dani1560/SDR_Doppler_Radar_Pluto/photos/pluto_board_DFU_button_S1.jpeg

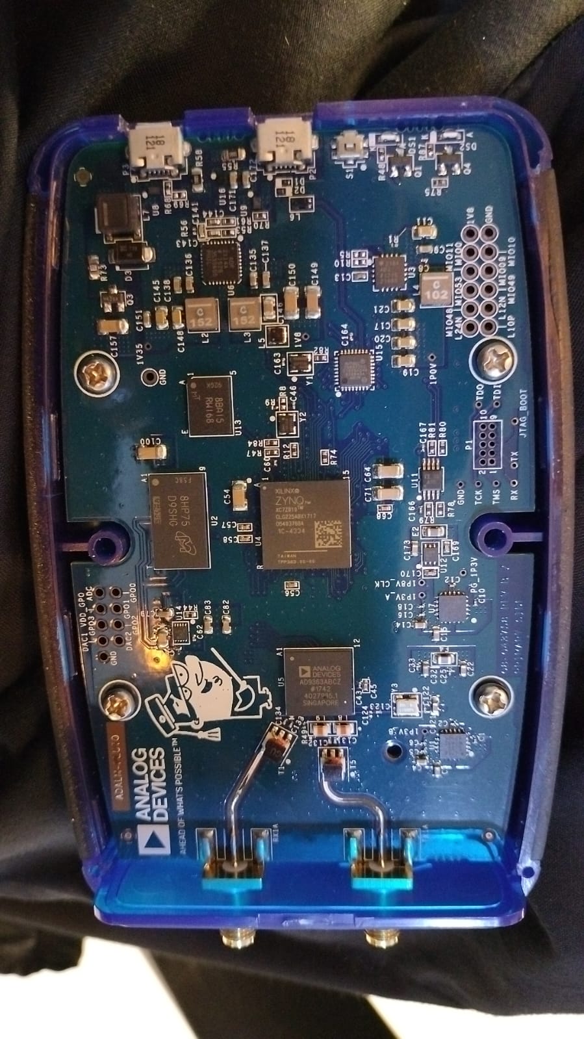
photos/pluto_board_DFU_button_S1.jpeg
