dani1560/SDR_Doppler_Radar_Pluto/docs/SDR_Radar_Deployment_Guide.pdf

Deployment Guide | SDR-Based Doppler Radar | PNEC-NUST

Final Year Project - Electronics & Power Engineering

# Run the Radar on a New Laptop

5 steps - about 30 minutes - internet needed once

1

Download the project: github.com/dani1560/SDR_Doppler_Radar_Pluto → Code → Download ZIP → unzip it.

2 Install Python from python.org. On the first screen tick Add python.exe to PATH.

3

Install the Pluto driver (Pluto unplugged): open the SDR_Radar_Deploy folder, double-click TOOLS.bat, press 6, click Yes to everything, then press 0.

4

Install GNU Radio: download radioconda for Windows from github.com/radioconda/radioconda-installer/releases and install it. Untick Add to PATH.

5

Plug in the Pluto (middle USB port) and the Arduino, wait 30 s, then double-click START_GNURADIO.bat.

Done. Stand still for 3 seconds, then move straight towards the antennas. Close the window to stop.

If something does not work

Problem | Fix
Pluto not found | Use the middle USB port, wait 30 s, close any other radar window
Arduino not found | Install the CH340 driver (wch-ic.com) or try another USB cable
Nothing detected | Move closer and straight towards the antennas; set the Min signal slider to 12
