dani1560/SDR_Doppler_Radar_Pluto/SDR_Radar_Deploy/03_alarm_test.py

"""
Step 3 - Arduino alarm test (no Pluto needed).

Sends simulated passes to the Arduino Nano so you can check the buzzer and LED display:
  1. slow, far   -> quiet, slow beeps
  2. medium      -> louder, faster beeps
  3. fast, close -> loudest, highest pitch, fastest beeps
After each pass the LED display should hold that pass's speed (one decimal, e.g. 15.0);
the fast pass is over the limit, so its speed blinks (captured).

Run:  python 03_alarm_test.py COM5      (or: python 03_alarm_test.py auto)
(Close the Arduino IDE Serial Monitor first.)
"""
import sys
import time
import serial

MAX_KMH = 60
PASSES = [            # (description, peak speed km/h, peak proximity %)
    ("slow and far", 15, 20),
    ("medium", 35, 60),
    ("fast and close", 72.4, 100),
]


def send(port, kmh, proximity, last):
    volume = min(max(kmh / MAX_KMH, 0.1), 1.0) * 100 if proximity > 0 else 0
    captured = int(last > MAX_KMH)                  # over the limit: the display blinks the held speed
    port.write(f"S{kmh:.1f},P{proximity:.0f},V{volume:.0f},L{last:.1f},F{captured}\n".encode())


def main():
    if len(sys.argv) < 2:
        print("Usage: python 03_alarm_test.py COM5   (or 'auto')")
        sys.exit(1)

    name = sys.argv[1]
    if name.lower() == "auto":
        from arduino_port import find_arduino_port
        name = find_arduino_port()
        if not name:
            sys.exit("No Arduino found. Is the Nano plugged in (and the CH340 driver installed)?")
        print(f"Arduino found on {name}")
    try:
        port = serial.Serial(name, 115200, timeout=0)
    except serial.SerialException as e:
        sys.exit(f"Cannot open {name}: {e}\nClose the Arduino IDE / Serial Monitor and try again.")
    time.sleep(2)                       # Nano resets when the port opens (8888 + chirp)
    last = -1.0

    try:
        for desc, peak_kmh, peak_prox in PASSES:
            print(f"Pass: {desc} - up to {peak_kmh} km/h, proximity {peak_prox}%")
            for i in range(40):          # 2 s approach: proximity and speed ramp up
                f = (i + 1) / 40
                send(port, peak_kmh * (0.8 + 0.2 * f), peak_prox * f, last)
                time.sleep(0.05)
            last = float(peak_kmh)
            note = "  (over the limit: blinking)" if last > MAX_KMH else ""
            print(f"  passed -> display should hold {last:.1f}{note}")
            for _ in range(60):          # 3 s quiet: display holds last speed
                send(port, 0, 0, last)
                time.sleep(0.05)
        print(f"Done. Display should show {last:.1f} (blinking)")
    finally:
        port.close()


if __name__ == "__main__":
    main()
