dani1560/SDR_Doppler_Radar_Pluto/(commit log)

2026-10-23 FYP SDR DOPLER RADAR PLUTO
    Low-cost SDR-based CW Doppler radar using ADALM-PLUTO at 2.48 GHz to measure vehicle speed in real time. Python DSP extracts the Doppler shift via FFT, rejects fan/Wi-Fi clutter, and logs each pass. An Arduino drives a buzzer that grows louder with speed and faster as targets approach, and an LED display holds the last measured speed.
    [01_pluto_test.py, 02_doppler_radar.py, 03_alarm_test.py]
2026-10-23 FYP SDR Doppler Radar
    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
    [01_pluto_test.py, 02_doppler_radar.py, 03_alarm_test.py, speed_alarm.ino]
2026-10-27 Add one-click launcher and make TX shutdown reliable
    - START_RADAR.bat: checks Python, packages and libiio, finds the Pluto
    and Arduino, and offers a menu (radar, tests, sketch upload, drivers).
    Replaces install.bat, run_radar.bat and run_radar_arduino.bat.
    - 02_doppler_radar.py: TX is destroyed and muted (-89 dB) on every exit
    path, including startup errors and console close; --port auto; the
    last pass is logged on exit; the display keeps the last speed.
    - 01_pluto_test.py: cleanup covers TX start, no cyclic-buffer phase jump,
    RX gain 30 dB (50 dB saturated with the antennas close together).
    - 03_alarm_test.py: accepts 'auto' for the COM port.
    - README updated for the launcher, an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
    [01_pluto_test.py, 02_doppler_radar.py, 03_alarm_test.py, arduino_port.py]
2026-10-27 Add speed-camera mode, simpler launcher, docs and PDF guides
    - Speed camera: each pass's peak speed is held and logged; passes over
    --limit are captured (red on screen, blinking on the LED, CSV column).
    - Sub-bin peak interpolation for a 0.1 km/h readout.
    - START_RADAR.bat starts the radar directly; TOOLS.bat holds the menu.
    - LED shows whole km/h on colon-only TM1637 modules (HAS_DOTS for modules
    with decimal points).
    - Root README, DEPLOY.md, project overview and student build guide PDFs.
2026-10-29 Add GNU Radio version with live frequency and max-speed control
    - gnuradio/doppler_radar.grc: PlutoSDR source/sink, Frequency Xlating FIR and
    FIR decimation to 8 kS/s, Doppler spectrum and waterfall, live/held speed
    labels, and sliders for frequency, max speed, speed limit, RX gain and TX
    attenuation.
    - gnuradio/doppler_camera_block.py: embedded Python "Doppler Speed Camera"
    block (detection, capture, log, Arduino); mutes TX when the flowgraph stops.
    - doppler_core.py: detector, speed conversion, pass tracking and logging shared
    by the GNU Radio and Python versions; frequency and max speed are parameters.
    - 02_doppler_radar.py: uses doppler_core; new --freq-mhz and --max-speed.
    - S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
2026-10-29 Show the last logged pass on the LED after a restart
    The Nano resets whenever the serial port opens and forgets the held speed.
    SpeedCamera now loads the last pass from speed_log.csv at start-up, so the
    LED and the GNU Radio LAST SPEED label show it until the next pass.
    [doppler_core.py]
2026-10-29 GNU Radio: warn on the screen when the receiver clips
    The TX-to-RX leakage is 0.8 of ADC full scale at the default settings, so
    less TX attenuation overloads the receiver. LIVE SPEED now shows a CLIPPING
    warning above 0.9 of full scale (tested: TX 5 dB/RX 30 dB clips, TX 0 dB/RX
    20 dB does not).
    [doppler_camera_block.py]
2026-10-29 Short-range defaults (about 1-2 m) and a Min signal setting
    - New Min signal slider (GNU Radio) and --min-signal option (Python): the
    signal a target needs above the noise. Higher = only closer targets.
    - Defaults for indoor demos: TX attenuation 30 dB, RX gain 30 dB, Min signal
    35 dB, Max speed 60 km/h, Speed limit 10 km/h. Tested with injected targets:
    a strong (near) target is measured within 0.02 km/h, a weak (far) one ignored.
    - TX attenuation 30 also keeps the TX leakage at 0.08 of full scale instead of
    0.8, which raised the test-target signal from 19 dB to 42 dB.
    - README: settings table and long-range settings.
    [02_doppler_radar.py, doppler_camera_block.py, doppler_core.py]
2026-10-29 Faster LED update, blink on every new speed, max 50 km/h
    - FFT window 0.5 s -> 0.26 s (NFFT 2048) and pass end 1 s -> 0.4 s: the held
    speed reaches the LED about 0.75 s after the target leaves (was 2-3 s).
    Measured on the Pluto: 5-45 km/h within 0.04 km/h, both directions.
    - speed_alarm.ino: every new captured speed blinks for 5 s; a pass over the
    limit keeps blinking.
    - Max speed default 50 km/h (GNU Radio and Python).
2026-10-29 Toy-car defaults: TX attenuation 20 dB, Min signal 15 dB
    A toy car echoes much less than a person. Measured in a 90 s room test with
    these settings: no false detections while nothing moved, and the car was
    detected when driven straight at the antennas (3-17 km/h, up to 47 dB).
2026-10-29 Update both PDFs and README for the current GNU Radio build
    - Six sliders incl. Min signal, default settings table with block IDs and how
    to change defaults in GNU Radio Companion.
    - Current numbers: 2048-point FFT (3.9 Hz bins, 0.85 km/h, 0.1 km/h readout),
    max speed 50 km/h default, held speed ~0.75 s after the target leaves.
    - LED behaviour (5 s blink, kept blinking over the limit, restored after a
    restart), range tips (toy car), room and toy car test results.
    - New figures: radar controls and Doppler spectrum.
2026-10-29 Presentation: replace MATLAB with GNU Radio
    Slides 4, 8, 9 and the block diagram image on slide 10 named MATLAB as the
    processing platform. They now say GNU Radio (3.10, gr-iio PlutoSDR blocks);
    everything else in the deck is unchanged. PDF re-exported from PowerPoint.
2026-10-29 PDFs: guide code examples match the current code; deck author
    - Student guide: detection example is now doppler_core.Detector (clutter map,
    Min signal, five candidate peaks); pass tracking is SpeedCamera.update; TX
    attenuation -20 dB; Python-only steps say so; held-speed timing (0.75 s).
    - Exercises kept on one page.
    - Presentation: author set to the project team (was the library name).
2026-10-29 Presentation matches the built project; current screenshots everywhere
    Deck (now 17 slides):
    - 2.482 GHz carrier, AD9363 / 20 MHz, specs from the code (2048-point FFT,
    0.85 km/h bins with 0.1 km/h readout, 50 km/h default up to 740 km/h).
    - Signal processing flow: mixing to 0 Hz and 8 kS/s, FFT with clutter map,
    output in GNU Radio and on the LED.
    - New system diagram: one PlutoSDR (TX and RX), one laptop with the GNU Radio
    blocks, Arduino LED and buzzer, speed log.
    - New slides: GNU Radio Implementation (radar window) and Test Results.
    - Budget: miscellaneous is the Arduino, LED display and buzzer.
    - Conclusion names the speed camera, LED display and adjustable settings.
    Overview / gu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
2026-10-29 Louder buzzer: 1.8-3.6 kHz tone, 30-50 % duty cycle
    A passive buzzer is loudest around 2-4 kHz; the old 600-1200 Hz tone with a
    2 % minimum duty cycle was very quiet when driven straight from D9.
    [speed_alarm.ino]
2026-10-29 Buzzer at full volume with push-pull drive on D9/D10
    D10 (OC1B, inverted) is the inverse of D9, so a piezo buzzer wired between D9
    and D10 sees a 10 V swing instead of 5 V. The duty cycle is always 50 %, the
    loudest a square wave gets. Wiring between D9 and GND still works.
    [speed_alarm.ino]
2026-10-29 README: buzzer wiring options (D9-D10 push-pull, D9-GND, BC547 driver)
2026-10-30 Docs match the current project; buzzer at its loudest pitch
    - READMEs and DEPLOY.md: 2048-point FFT, max speed default 50 km/h, Python
    defaults (limit 10 km/h, TX -20 dB, Min signal 15 dB), Min signal slider,
    how to change GNU Radio defaults, buzzer wiring and troubleshooting; the
    laptop-speaker alarm is the Python version only.
    - speed_alarm.ino: buzzer at 3.1-3.3 kHz (its loudest pitch, measured with a
    microphone) with long beeps (75 % on), start-up chirp at 3.2 kHz.
    [speed_alarm.ino]
2026-10-30 Add the GNU Radio Companion flowgraph to the PDFs, presentation and READMEs
    - photos/gnuradio_flowgraph.png: the flowgraph as shown in GNU Radio Companion.
    - Overview (Figure 3) and student guide (Figure 2), later figures renumbered.
    - Presentation: new slide 12 "GNU Radio Flowgraph" (now 18 slides).
    - Root and deploy READMEs show the flowgraph.
2026-11-02 Add a one-page deployment guide; flowgraph re-saved by GNU Radio Companion (no setting changes)
